xms12138/Tea-for-Three/Picture/Main view.jpg

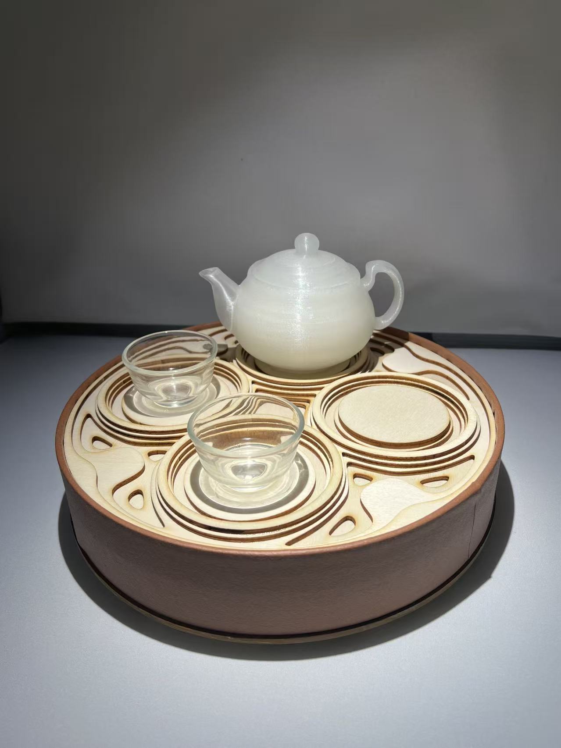
Picture/Main view.jpg
