xms12138/Tea-for-Three/(commit log)

2026-04-26 Enhance README with comprehensive project details
    Expanded the README with detailed project information, including introduction, literature review, problem statement, project objectives, design iterations, prototype overview, evaluation, and references.
2026-04-26 Revise prototype overview and design sections
    Updated sections on the initial concept, 3D printing version, and final prototype design, including images and descriptions.
